sbrown4/esphome-dsckeybus/extras/pcb layouts/SeeedMCU/dscKeybus.csv

Id | Designator | Footprint | Quantity | Designation | Supplier and ref
1 | J1 | TE_282837-4 | 1 | Screw_Terminal_01x04
2 | J2 | PinHeader_1x02_P2.54mm_Vertical | 1 | Conn_01x02_Pin
3 | J3 | PinSocket_1x03_P2.54mm_Vertical | 1 | Conn_01x03_Socket
4 | Q1 | TO-92_Inline | 1 | 2N3904
5 | Q2, Q3 | TO-92_Inline | 2 | 2N7000
6 | R1 | R_Axial_DIN0207_L6.3mm_D2.5mm_P7.62mm_Horizontal | 1 | 1k
7 | U1 | XIAO-ESP32S3-DIP | 1 | XIAO-ESP32-S3-DIP
8 | U2 | MP1584EN_Power_Module_5VDC | 1 | MP1848EN
