sbrown4/esphome-dsckeybus/extras/pcb layouts/SeeedMCU/3D/2N7000-G--3DModel-STEP-510211.STEP

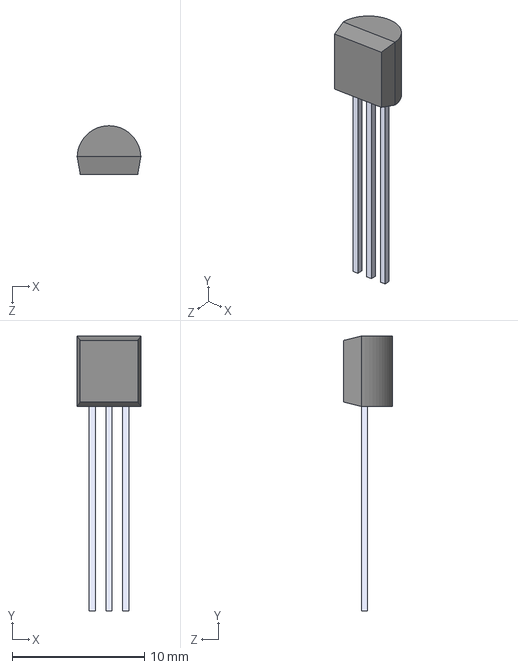
[picture p1: CAD file, 2026-10-08]
extras/pcb layouts/SeeedMCU/3D/2N7000-G--3DModel-STEP-510211.STEP
4.83 x 20.8 x 3.68 mm
