sbrown4/esphome-dsckeybus/extras/pcb layouts/SeeedMCU/3D/534237-5.step

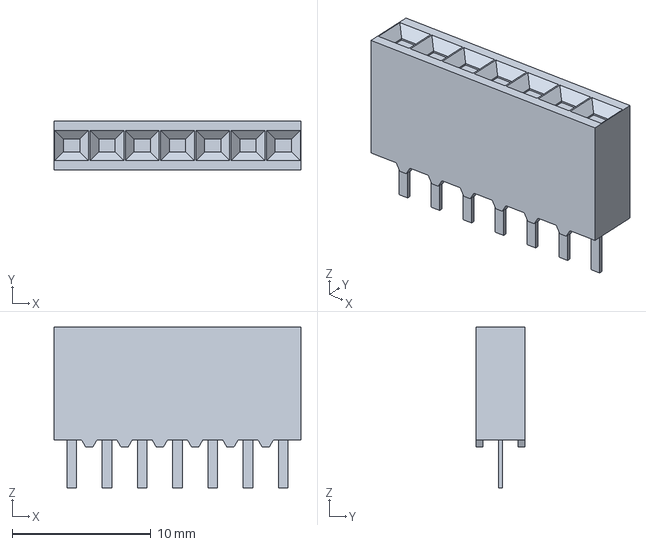
[picture p3: CAD file, 2026-10-08]
extras/pcb layouts/SeeedMCU/3D/534237-5.step
17.8 x 3.56 x 11.6 mm
