sbrown4/esphome-dsckeybus/extras/pcb layouts/SeeedMCU/3D/282837-4.step

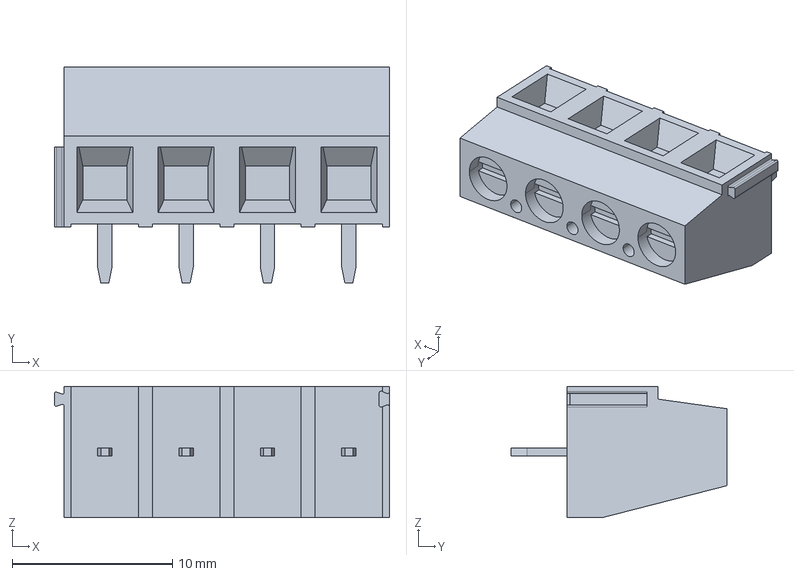
[picture p4: CAD file, 2026-10-08]
extras/pcb layouts/SeeedMCU/3D/282837-4.step
20.9 x 13.5 x 8.20 mm
