sbrown4/esphome-dsckeybus/extras/pcb layouts/SeeedMCU/dscKeybus.kicad_pcb

## KiCad design extras/pcb layouts/SeeedMCU/dscKeybus.kicad_pcb (2026-10-08)

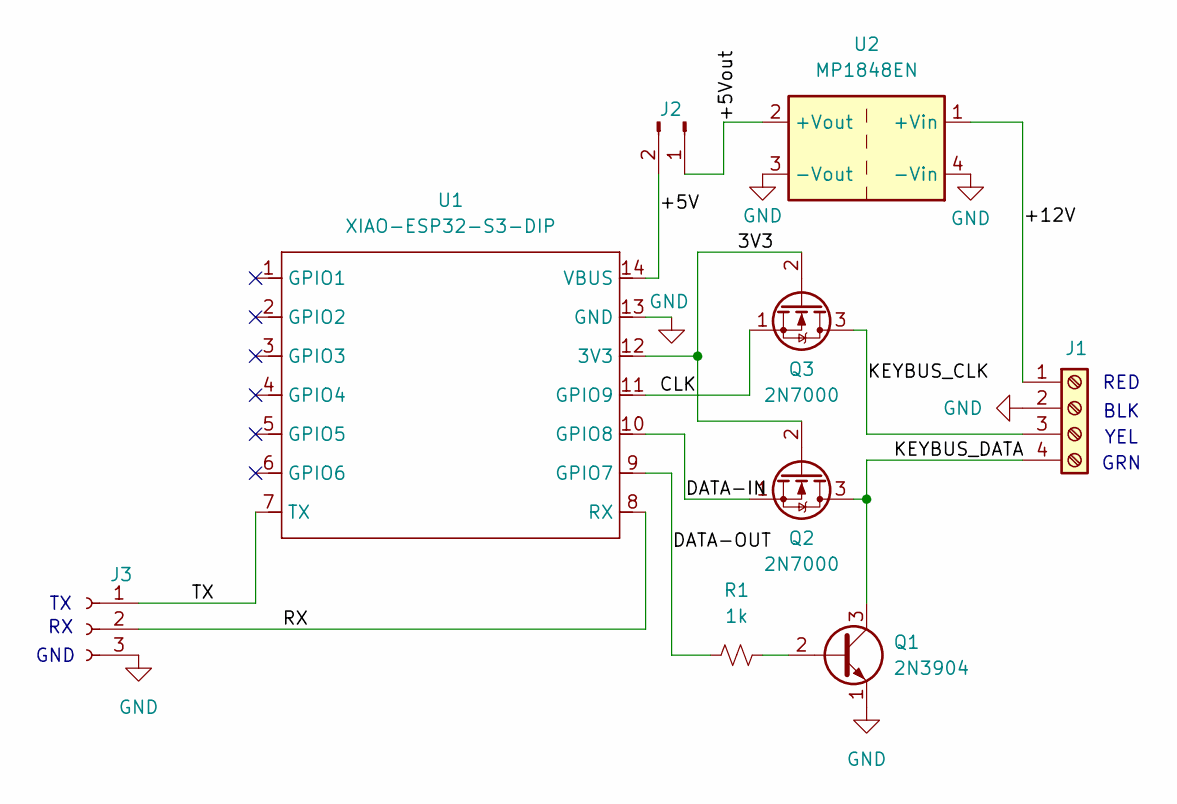
[picture p5: schematic dscKeybus.kicad_sch]

Parts:
J1: Screw_Terminal_01x04; TE_282837-4
J2: Conn_01x02_Pin; PinHeader_1x02_P2.54mm_Vertical
J3: Conn_01x03_Socket; PinSocket_1x03_P2.54mm_Vertical
Q1: 2N3904; TO-92_HandSolder
Q2, Q3: 2N7000; TO-92_HandSolder
R1: 1k; R_Axial_DIN0207_L6.3mm_D2.5mm_P7.62mm_Horizontal
U1: XIAO-ESP32-S3-DIP; XIAO-ESP32S3-DIP
U2: MP1848EN; MP1584EN_Power_Module_5VDC

Connections:
/3V3: Q2.2 (G), Q3.2 (G), U1.12 (3V3)
/+5V: J2.2, U1.14 (VBUS)
/+5Vout: J2.1, U2.2 (+Vout)
/+12V: J1.1, U2.1 (+Vin)
/CLK: Q3.1 (S), U1.11 (GPIO9)
/DATA-IN: Q2.1 (S), U1.10 (GPIO8)
/DATA-OUT: R1.2, U1.9 (GPIO7)
/KEYBUS_CLK: J1.3, Q3.3 (D)
/KEYBUS_DATA: J1.4, Q1.3 (C), Q2.3 (D)
/RX: J3.2, U1.8 (RX)
/TX: J3.1, U1.7 (TX)
GND: J1.2, J3.3, Q1.1 (E), U1.13 (GND), U2.3 (-Vout), U2.4 (-Vin)
unnamed: Q1.2 (B), R1.1

Notes on the sheet:
RED
GRN
YEL
GND
BLK

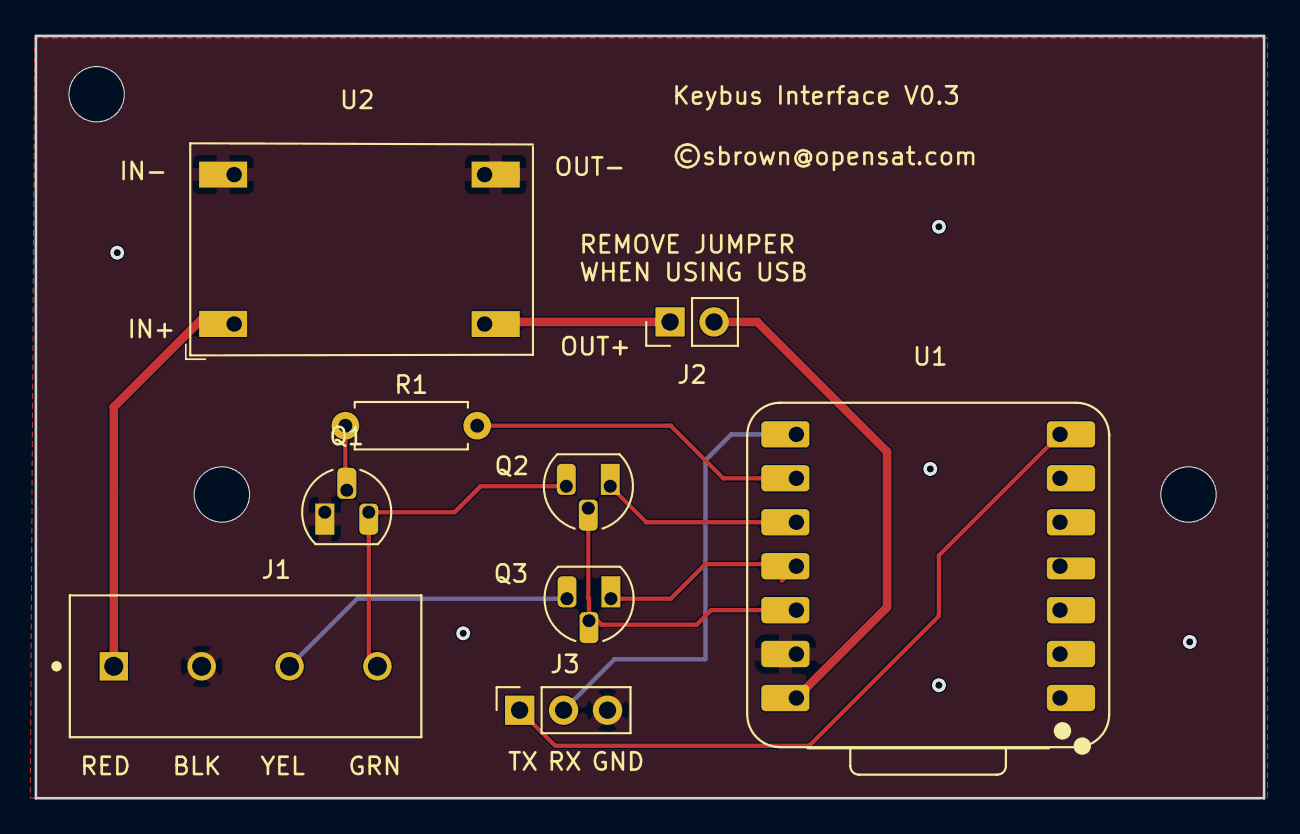
[picture p6: board dscKeybus.kicad_pcb from above]

Board: 2 copper layers, 71.0 x 44.1 mm, 9 parts (0 on the bottom side), 13 nets.
