sbrown4/esphome-dsckeybus/(notices)

Notices in the files:
extras/pcb layouts/SeeedMCU/dscKeybus.kicad_pcb:
©sbrown@opensat.com
